n2048-creative-technology/butterflyeffect/poetry monitors butterfly.pdf

I’ve been missing
this time together
the smell of
the flowers,
the fresh air

Today,
I feel on the edge
of something
I cannot name.
not life
not death
not dream

a hallway that
extends
endlessly
right before me
and yet it ends

where are
my roots growing?
where are they
leading me?
To me, to you

the silence around me
seemed alive
restless
waiting

as if the walls
were listening
for a word
I could not say.

So spoke the land
of oblivion,
stretching outward,
weary of existing
within the intimate,
sensual
nature of things.

A pact forged
between life and death,
in the hope
that the end of one
might become
the beginning of another.

How easy it is for humankind still to say:
*In dreams,
we shall find one another again.*

And so you endure,
with an exhausted ferocity, skin against skin,
body against body,
filling your lungs
with generous air.

In the uncertainty
of what is to come,
a song unfolds
a lullaby
carrying the primordial
memory of being.

She beats her wings.
The song falls silent,
hanging
between one heartbeat
and the next,
as though time
had forgotten
to move on.

And in that emptiness,
at last,
that lost word
needed no more.
