n2048-creative-technology/butterflyeffect/(list of files, cad)

Other CAD files:
leaf/leaf/leaf.blend
