n2048-creative-technology/butterflyeffect/(list of files, drawings)

Other design files:
esp32-s3/freerouting.dsn
esp32-s3/temp-freerouting.dsn
PCB/leaf2/freerouting.dsn
PCB/leaf/temp-freerouting.dsn
