n2048-creative-technology/butterflyeffect/PCB/leaf/leaf.kicad_pcb

## KiCad design PCB/leaf/leaf.kicad_pcb (2026-08-15)

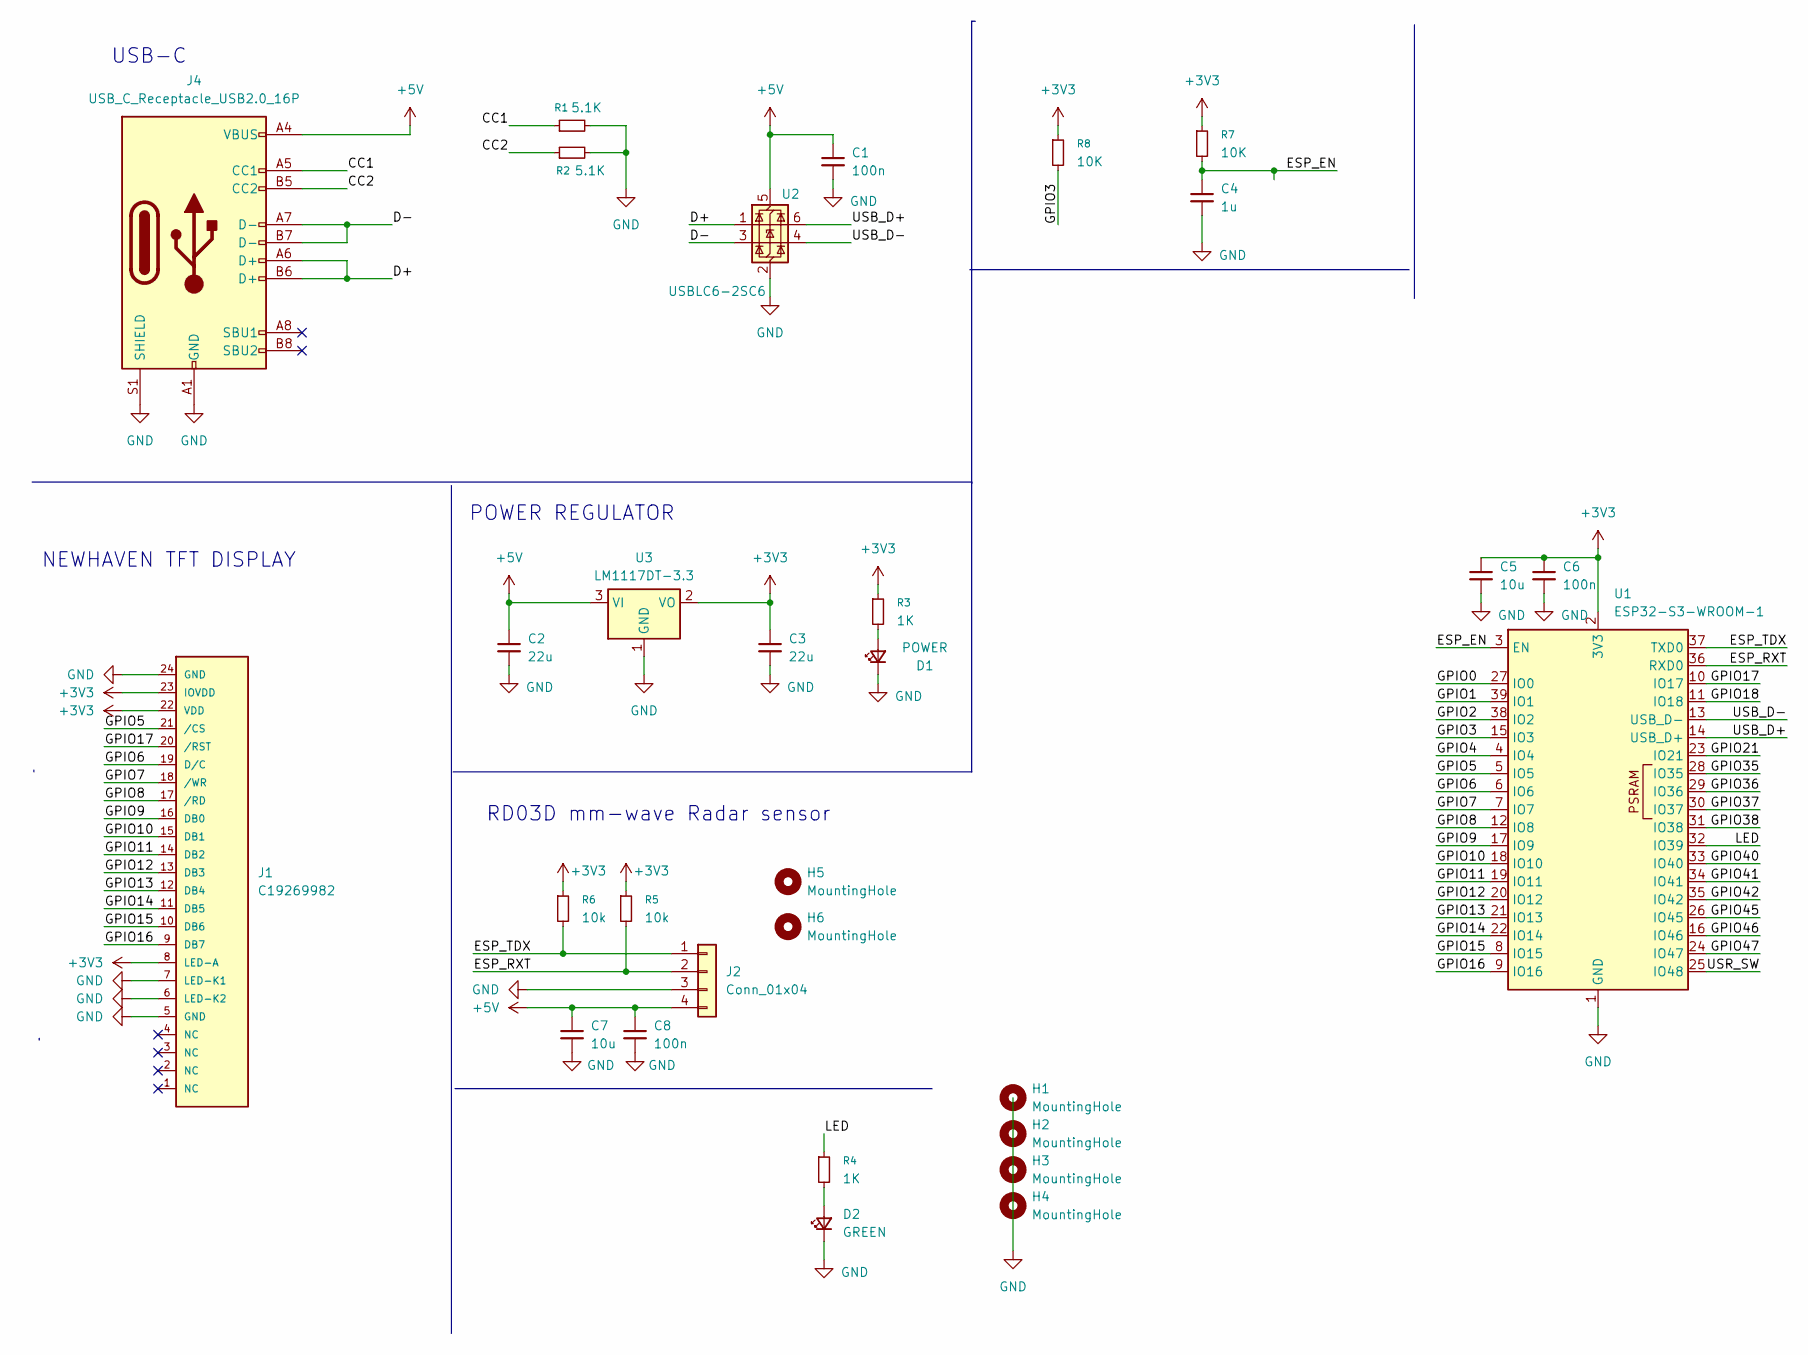
[picture p1: schematic leaf.kicad_sch, ESP32-S3]

Parts:
C1, C6, C8: 100n; C_01005_0402Metric_Pad0.57x0.30mm_HandSolder
C2, C3: 22u; C_1210_3225Metric
C4: 1u; C_0603_1608Metric
C5, C7: 10u; C_0603_1608Metric
D1: POWER; LED_0603_1608Metric
D2: GREEN; LED_0603_1608Metric
H1, H2, H3, H4: MountingHole; MountingHole_4.3mm_M4_ISO14580_Pad
H5, H6: MountingHole; MountingHole_2.2mm_M2_ISO7380_Pad
J1: C19269982; Molex_502244-2430_1x24-1MP_P0.5mm_Horizontal
J2: Conn_01x04; Molex_PicoBlade_53261-0471_1x04-1MP_P1.25mm_Horizontal
J4: USB_C_Receptacle_USB2.0_16P; USB_C_Receptacle_GCT_USB4105-xx-A_16P_TopMnt_Horizontal
R1, R2: 5.1K; R_0402_1005Metric_Pad0.72x0.64mm_HandSolder
R3, R4: 1K; R_0402_1005Metric_Pad0.72x0.64mm_HandSolder
R5, R6: 10k; R_0402_1005Metric_Pad0.72x0.64mm_HandSolder
R7, R8: 10K; R_0402_1005Metric_Pad0.72x0.64mm_HandSolder
U1: ESP32-S3-WROOM-1
U2: USBLC6-2SC6; SOT-23-6
U3: LM1117DT-3.3; TO-252-3_TabPin2

Connections:
+3V3: C3.1, C5.1, C6.1, J1.8 (LED-A), J1.22 (VDD), J1.23 (IOVDD), R3.1, R5.1, R6.1, R7.1, R8.1, U1.2 (3V3), U3.2 (VO)
+5V: C1.1, C2.1, C7.1, C8.1, J2.4, J4.A4 (VBUS), J4.A9 (VBUS), J4.B4 (VBUS), J4.B9 (VBUS), U2.5 (VBUS), U3.3 (VI)
/CC1: J4.A5 (CC1), R1.1
/CC2: J4.B5 (CC2), R2.1
/D+: J4.A6 (D+), J4.B6 (D+), U2.1 (I/O1)
/D-: J4.A7 (D-), J4.B7 (D-), U2.3 (I/O2)
/ESP_EN: C4.1, R7.2, U1.3 (EN)
/ESP_RXT: J2.2, R5.2, U1.36 (RXD0)
/ESP_TDX: J2.1, R6.2, U1.37 (TXD0)
/GPIO0: U1.27 (IO0)
/GPIO1: U1.39 (IO1)
/GPIO2: U1.38 (IO2)
/GPIO3: R8.2, U1.15 (IO3)
/GPIO4: U1.4 (IO4)
/GPIO5: J1.21 (/CS), U1.5 (IO5)
/GPIO6: J1.19 (D/C), U1.6 (IO6)
/GPIO7: J1.18 (/WR), U1.7 (IO7)
/GPIO8: J1.17 (/RD), U1.12 (IO8)
/GPIO9: J1.16 (DB0), U1.17 (IO9)
/GPIO10: J1.15 (DB1), U1.18 (IO10)
/GPIO11: J1.14 (DB2), U1.19 (IO11)
/GPIO12: J1.13 (DB3), U1.20 (IO12)
/GPIO13: J1.12 (DB4), U1.21 (IO13)
/GPIO14: J1.11 (DB5), U1.22 (IO14)
/GPIO15: J1.10 (DB6), U1.8 (IO15)
/GPIO16: J1.9 (DB7), U1.9 (IO16)
/GPIO17: J1.20 (/RST), U1.10 (IO17)
/GPIO18: U1.11 (IO18)
/GPIO21: U1.23 (IO21)
/GPIO35: U1.28 (IO35)
/GPIO36: U1.29 (IO36)
/GPIO37: U1.30 (IO37)
/GPIO38: U1.31 (IO38)
/GPIO40: U1.33 (IO40)
/GPIO41: U1.34 (IO41)
/GPIO42: U1.35 (IO42)
/GPIO45: U1.26 (IO45)
/GPIO46: U1.16 (IO46)
/GPIO47: U1.24 (IO47)
/LED: R4.1, U1.32 (IO39)
/USB_D+: U1.14 (USB_D+), U2.6 (I/O1)
/USB_D-: U1.13 (USB_D-), U2.4 (I/O2)
/USR_SW: U1.25 (IO48)
GND: C1.2, C2.2, C3.2, C4.2, C5.2, C6.2, C7.2, C8.2, D1.1 (K), D2.1 (K), J1.5 (GND), J1.6 (LED-K2), J1.7 (LED-K1), J1.24 (GND), J1.MP, J2.3, J2.MP, J4.A1 (GND), J4.A12 (GND), J4.B1 (GND), J4.B12 (GND), J4.S1 (SHIELD), R1.2, R2.2, U1.1 (GND), U1.40 (GND), U1.41 (GND), U2.2 (GND), U3.1 (GND)
unnamed: D1.2 (A), R3.2
unnamed: D2.2 (A), R4.2

Notes on the sheet:
NEWHAVEN TFT DISPLAY
USB-C
POWER REGULATOR
RD03D mm-wave Radar sensor

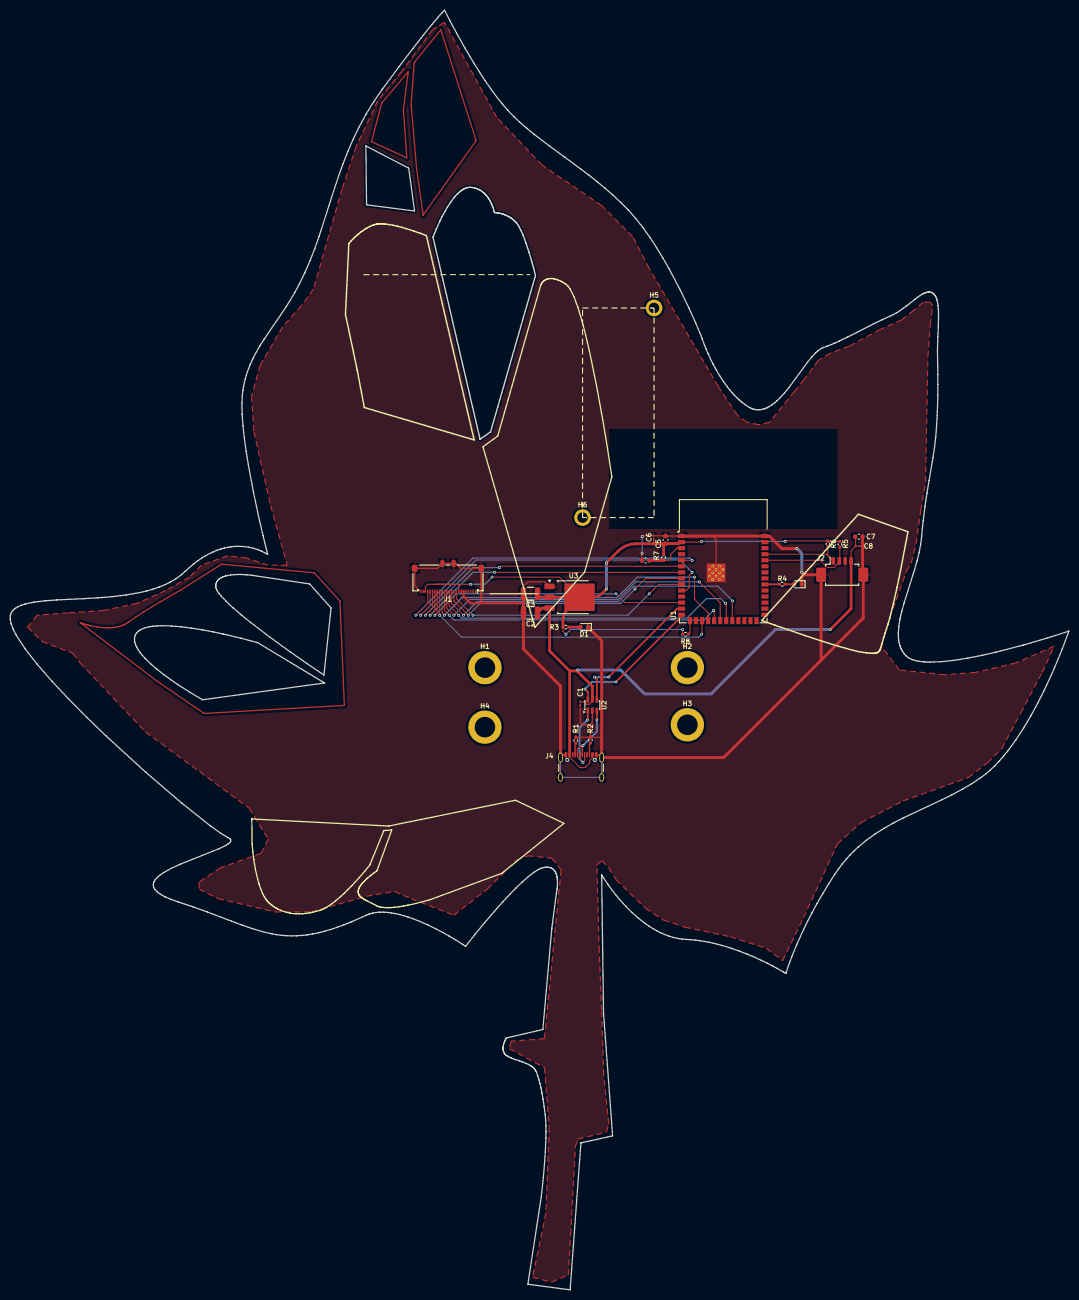
[picture p2: board leaf.kicad_pcb from above]

Board: 2 copper layers, 222.3 x 268.6 mm, 30 parts (0 on the bottom side), 29 nets.
