n2048-creative-technology/butterflyeffect/esp32-s3/esp32-s3.kicad_pcb

## KiCad design esp32-s3/esp32-s3.kicad_pcb (2026-06-12)

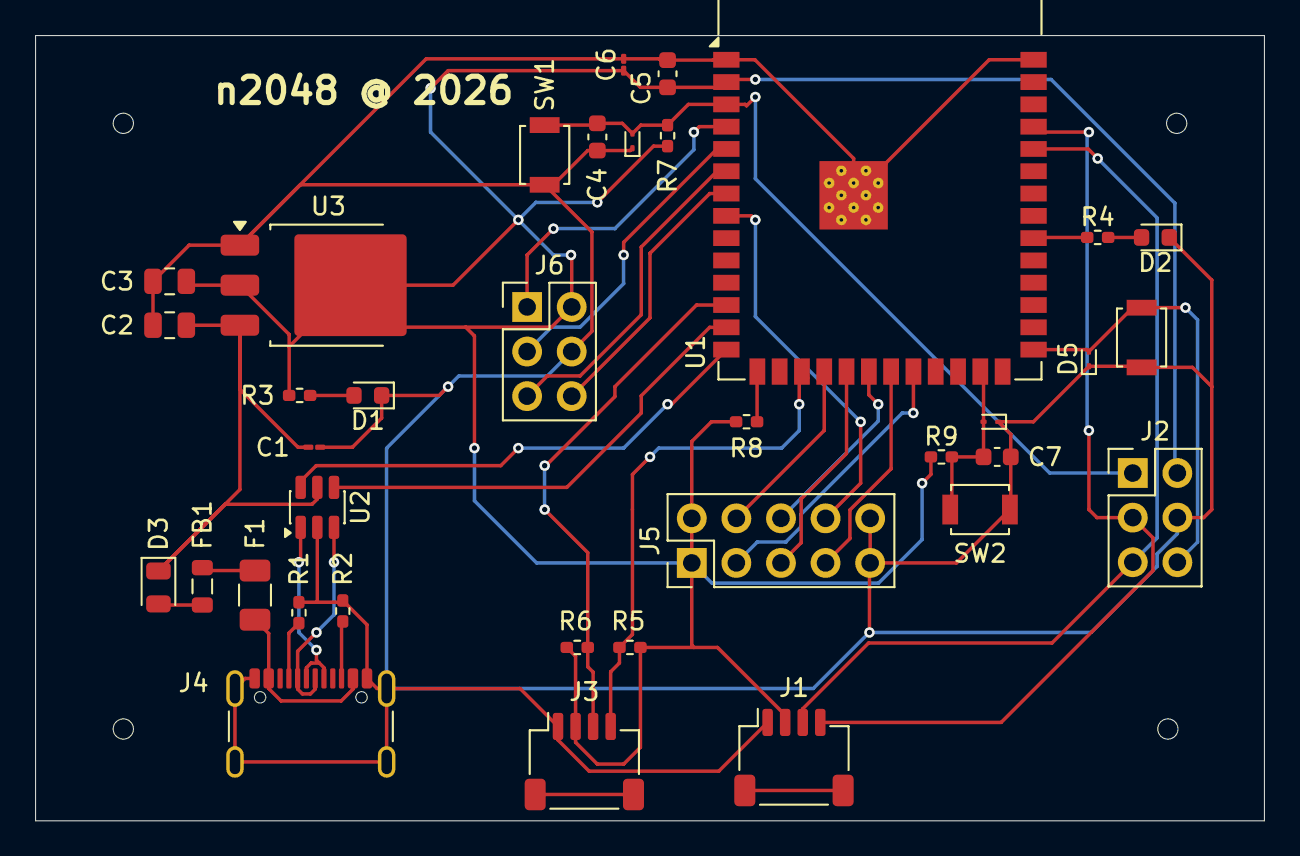
[picture p3: board esp32-s3.kicad_pcb from above]

Board: 2 copper layers, 70.0 x 44.7 mm, 40 parts (0 on the bottom side), 33 nets.

Parts:
C1, C6: 100n; C_01005_0402Metric_Pad0.57x0.30mm_HandSolder
C2, C3: 22u; C_0805_2012Metric
C4, C7: 1u; C_0603_1608Metric
C5: 10u; C_0603_1608Metric
D1: POWER; LED_0603_1608Metric
D2: GREEN; LED_0603_1608Metric
D3: 1N5817; D_0805_2012Metric
D4, D5, D6: ESD3.3; D_SOD-923
F1: Polyfuse 1A; Fuse_1206_3216Metric
FB1: BLM21PG220; L_0805_2012Metric
H1, H2, H3, H4: MountingHole; ToolingHole_1.152mm
J1, J3: Conn_01x04; JST_SH_SM04B-SRSS-TB_1x04-1MP_P1.00mm_Horizontal
J2, J6: Conn_02x03_Odd_Even; PinHeader_2x03_P2.54mm_Vertical
J4: USB_C_Receptacle_USB2.0_16P; USB_C_Receptacle_GCT_USB4105-xx-A_16P_TopMnt_Horizontal
J5: PIN 02x05; PinHeader_2x05_P2.54mm_Vertical
R1, R2: 5.1K; R_0402_1005Metric_Pad0.72x0.64mm_HandSolder
R3, R4: 1K; R_0402_1005Metric_Pad0.72x0.64mm_HandSolder
R5, R6: 2K2; R_0402_1005Metric_Pad0.72x0.64mm_HandSolder
R7, R8, R9: 10K; R_0402_1005Metric_Pad0.72x0.64mm_HandSolder
SW1: RESET; SW_SPST_B3U-1000P
SW2: USER_BTN; SW_SPST_B3U-1000P
SW3: BOOT; SW_SPST_B3U-1000P
U1: ESP32-S3-WROOM-1
U2: USBLC6-2SC6; SOT-23-6
U3: LM1117DT-3.3; TO-252-3_TabPin2

Connections:
+3V3: C3.1, C5.1, C6.1, J1.2, J2.2, J3.2, J5.1, J5.2, J6.2, R3.1, R5.1, R6.1, R7.1, R8.1, R9.1, U1.2 (3V3), U3.2 (VO)
+5V: C1.1, C2.1, D3.1 (K), U2.5 (VBUS), U3.3 (VI)
/CC1: J4.A5 (CC1), R1.1
/CC2: J4.B5 (CC2), R2.1
/CLK: J5.6, U1.20 (IO12)
/CS: J5.4, U1.18 (IO10)
/D+: J4.A6 (D+), J4.B6 (D+), U2.1 (I/O1)
/D-: J4.A7 (D-), J4.B7 (D-), U2.3 (I/O2)
/ESP_EN: C4.1, D4.2 (A2), J2.1, R7.2, SW1.2 (B), U1.3 (EN)
/ESP_RXT: J1.3, J2.5, U1.36 (RXD0)
/ESP_TDX: J1.4, J2.3, U1.37 (TXD0)
/GPIO0: D5.2 (A2), J2.6, SW3.2 (B), U1.27 (IO0)
/GPIO3: R8.2, U1.15 (IO3)
/GPIO4: J6.1, U1.4 (IO4)
/GPIO5: J6.3, U1.5 (IO5)
/GPIO6: J6.5, U1.6 (IO6)
/GPIO7: J6.6, U1.7 (IO7)
/IRQ: J5.8, U1.8 (IO15)
/LED: R4.1, U1.32 (IO39)
/MISO: J5.7, U1.21 (IO13)
/MOSI: J5.5, U1.19 (IO11)
/RESET: J5.3, U1.22 (IO14)
/SCL: J3.4, R5.2, U1.17 (IO9)
/SDA: J3.3, R6.2, U1.12 (IO8)
/USB_D+: U1.14 (USB_D+), U2.6 (I/O1)
/USB_D-: U1.13 (USB_D-), U2.4 (I/O2)
/USR_SW: C7.1, D6.2 (A2), R9.2, SW2.2 (B), U1.25 (IO48)
GND: C1.2, C2.2, C3.2, C4.2, C5.2, C6.2, C7.2, D1.1 (K), D2.1 (K), D4.1 (A1), D5.1 (A1), D6.1 (A1), J1.1, J2.4, J3.1, J4.A1 (GND), J4.A12 (GND), J4.B1 (GND), J4.B12 (GND), J4.S1 (SHIELD), J5.9, J5.10, J6.4, R1.2, R2.2, SW1.1 (A), SW2.1 (A), SW3.1 (A), U1.1 (GND), U1.40 (GND), U1.41 (GND), U2.2 (GND), U3.1 (GND)
unnamed: D1.2 (A), R3.2
unnamed: D2.2 (A), R4.2
unnamed: D3.2 (A), FB1.2
unnamed: F1.1, J4.A4 (VBUS), J4.A9 (VBUS), J4.B4 (VBUS), J4.B9 (VBUS)
unnamed: F1.2, FB1.1
