n2048-creative-technology/butterflyeffect/(commit log)

2026-06-19 functional text glitch effect
    [main.cpp]
2026-06-19 add radar sensor to determine glitch intensity
    [main.cpp]
2026-06-19 mechanical wings design
    [wings.scad]
